yaturner/tcam-a1-mount/stl/case_base_a1.stl

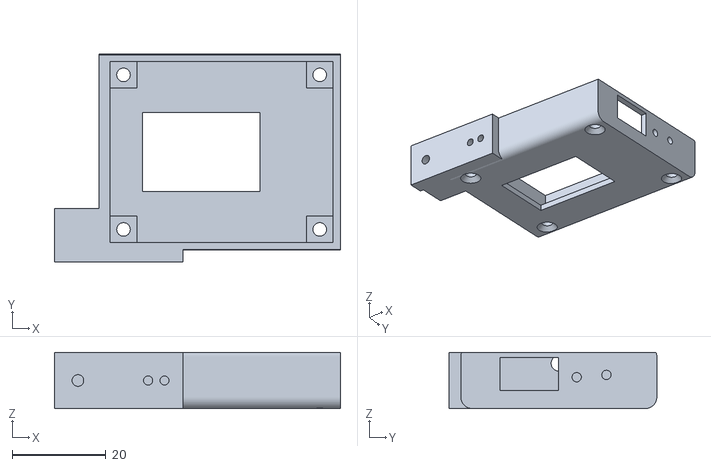
[picture p3: CAD file, 2026-11-11]
stl/case_base_a1.stl
61.1 x 44.4 x 12.0
