yaturner/tcam-a1-mount/stl/bracket_a1.stl

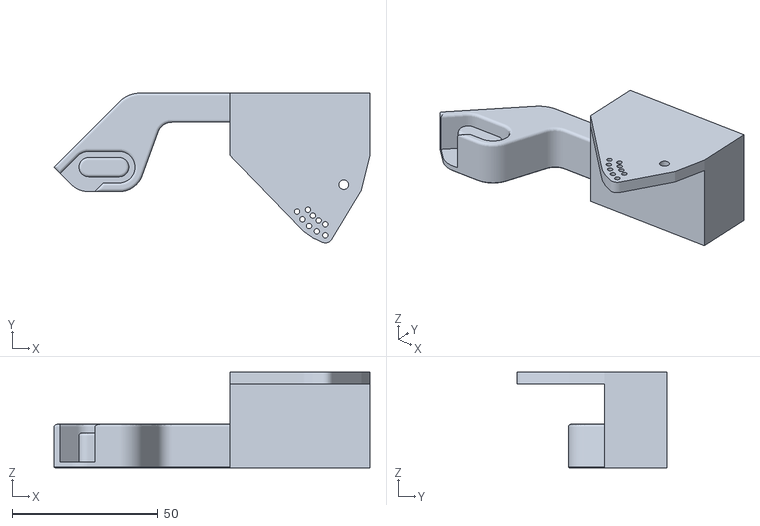
[picture p4: CAD file, 2026-11-11]
stl/bracket_a1.stl
108.4 x 51.4 x 32.9
