yaturner/tcam-a1-mount/stl/case_lid.stl

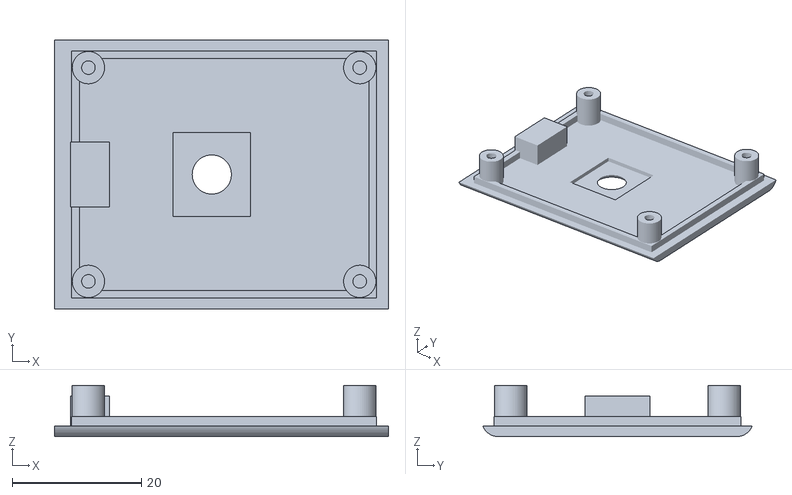
[picture p5: CAD file, 2026-11-11]
stl/case_lid.stl
51.6 x 41.6 x 7.90
