yaturner/tcam-a1-mount/(list of files, cad)

Other CAD files:
tcam_p1s_mount.scad
