yaturner/tcam-a1-mount/docs/a1_assembly.pdf

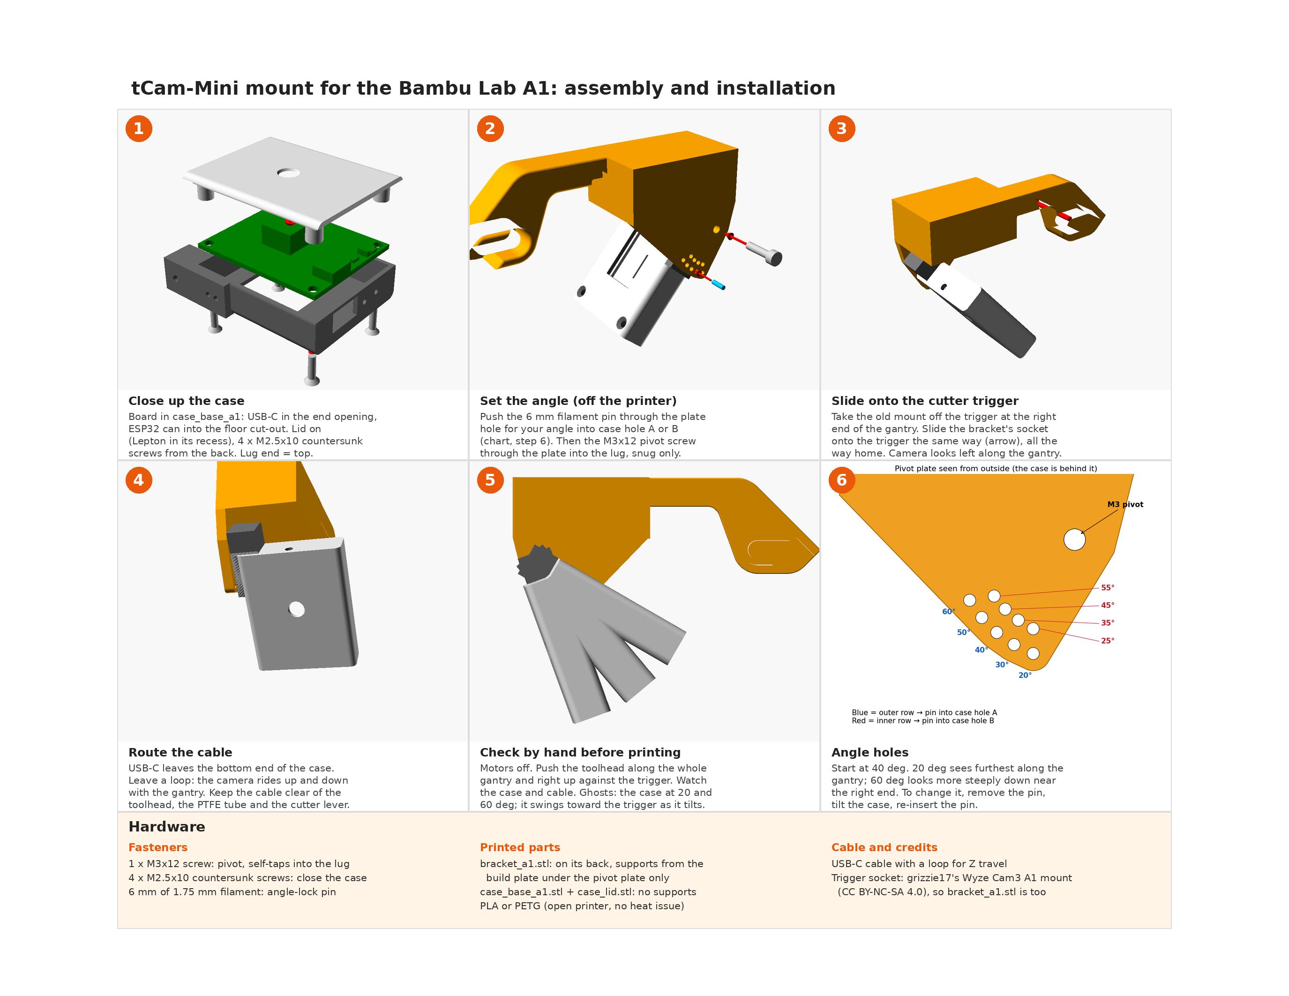
[picture p6: page 1]
