yaturner/tcam-a1-mount/(commit log)

2026-11-11 tCam-Mini mount for the Bambu Lab A1 (cutter-trigger bracket)
    One-piece bracket on the A1's filament-cutter trigger with a pin-locked
    20-60 deg tilt, plus a side-pivot variant of the tCam-Mini case base.
    The trigger socket is grizzie17's Wyze Cam3 A1 interface (CC BY-NC-SA 4.0),
    so bracket_a1.stl carries that license; the rest is MIT.
    [bracket_a1.stl, case_base_a1.stl, case_lid.stl, tcam_a1_mount.scad, tcam_p1s_mount.scad]
2026-11-11 Add assembly diagram (PNG + printable PDF) and link it in the README
